thunder439/QNAS8/README.md

# QNAS8
8盘位3D打印NAS
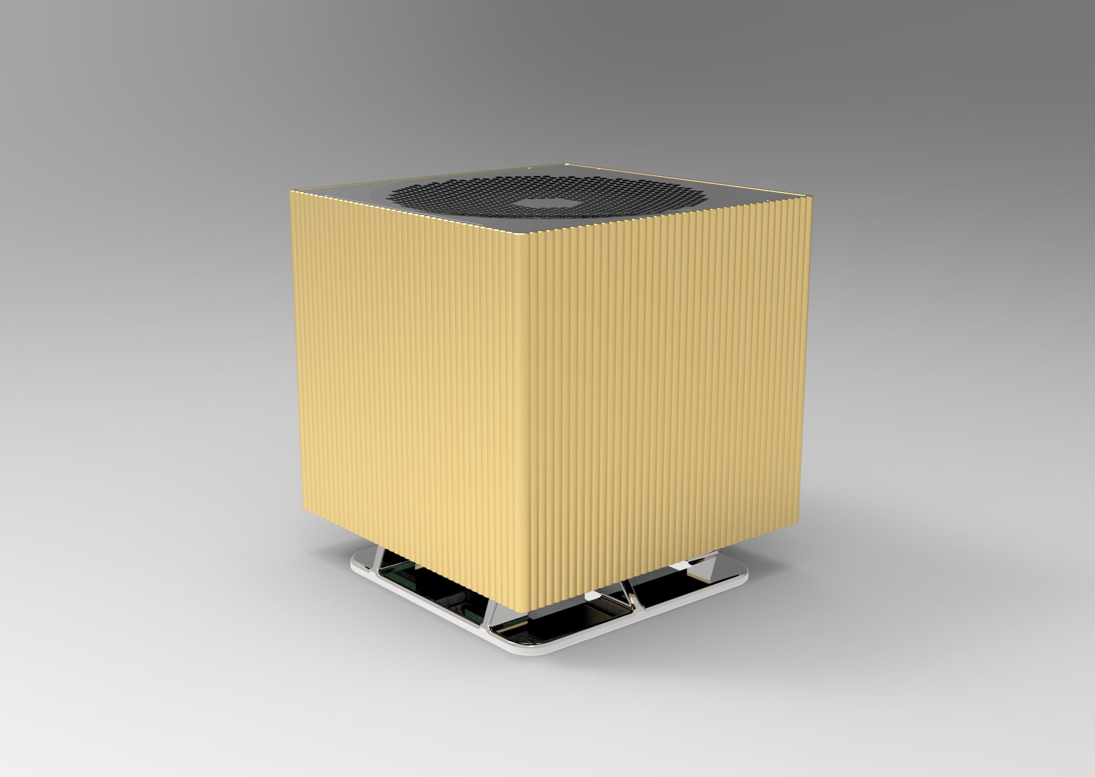
[picture p1: QNAS81.jpg]

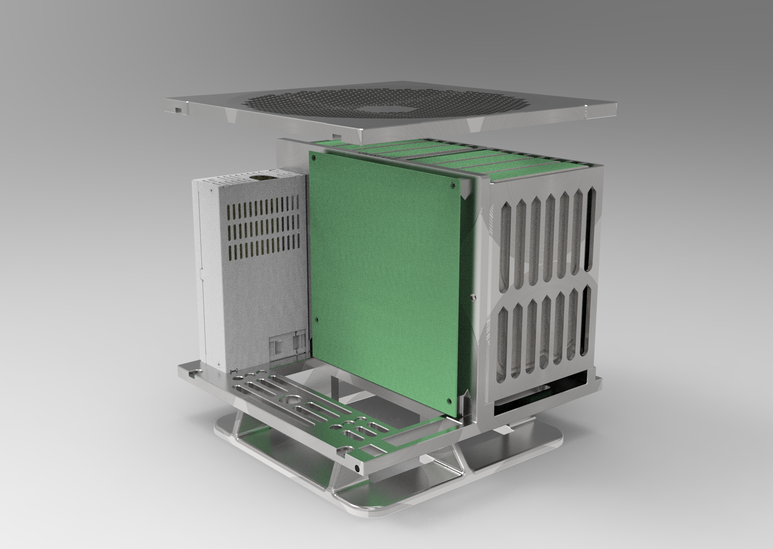
[picture p2: QNAS8内部.jpg]
