thunder439/QNAS8/Qnas8.jpg

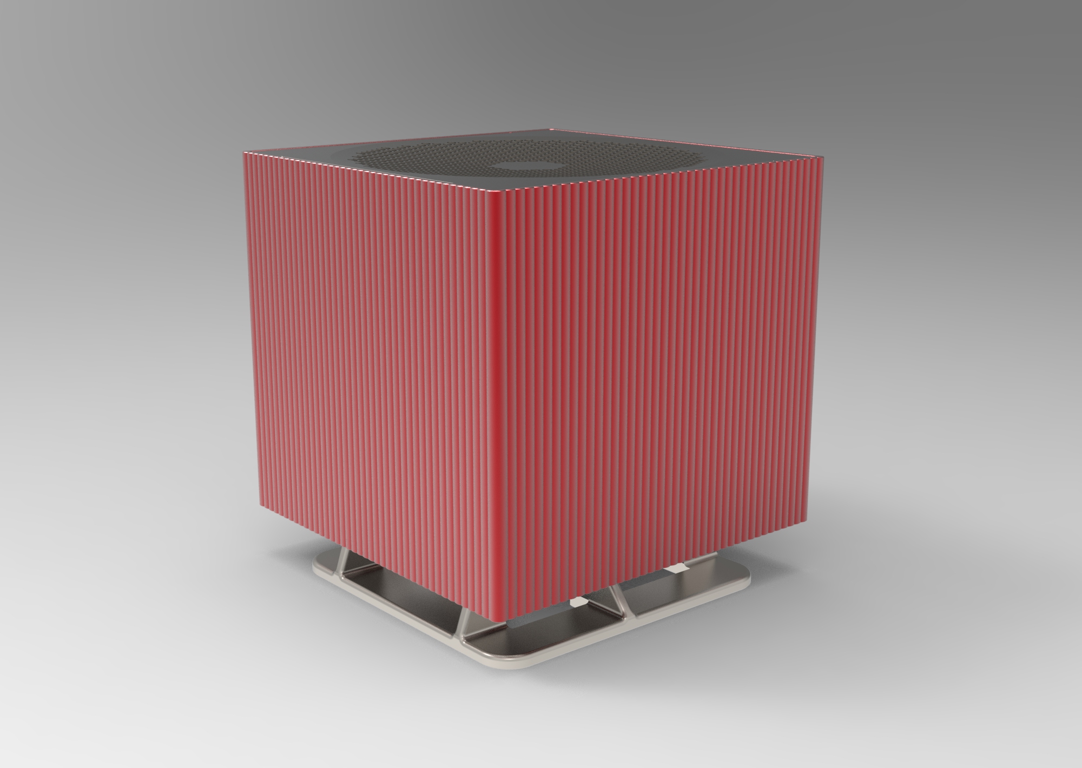
Qnas8.jpg
