thunder439/QNAS8/STL/新中框.STL

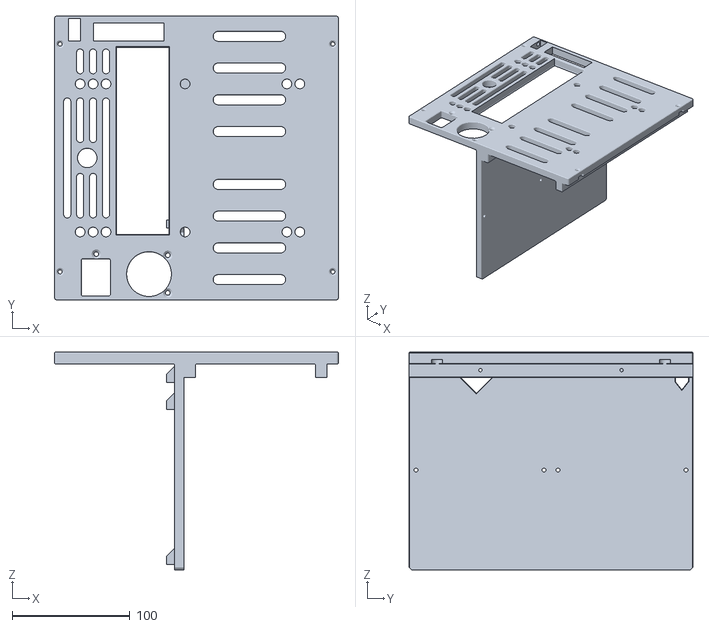
[picture p4: CAD file, 2023-04-15]
STL/新中框.STL
241.5 x 241.5 x 185.0
