thunder439/QNAS8/STL/硬盘笼实体.STL

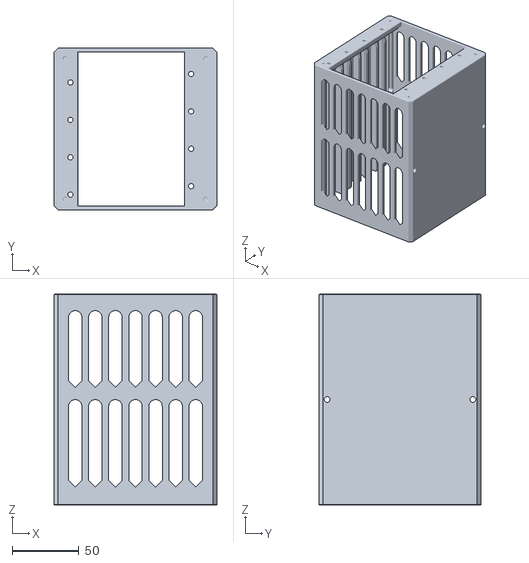
[picture p5: CAD file, 2023-04-15]
STL/硬盘笼实体.STL
121.4 x 120.7 x 157.5
