thunder439/QNAS8/STL/硬盘笼水滴版20230401.STL

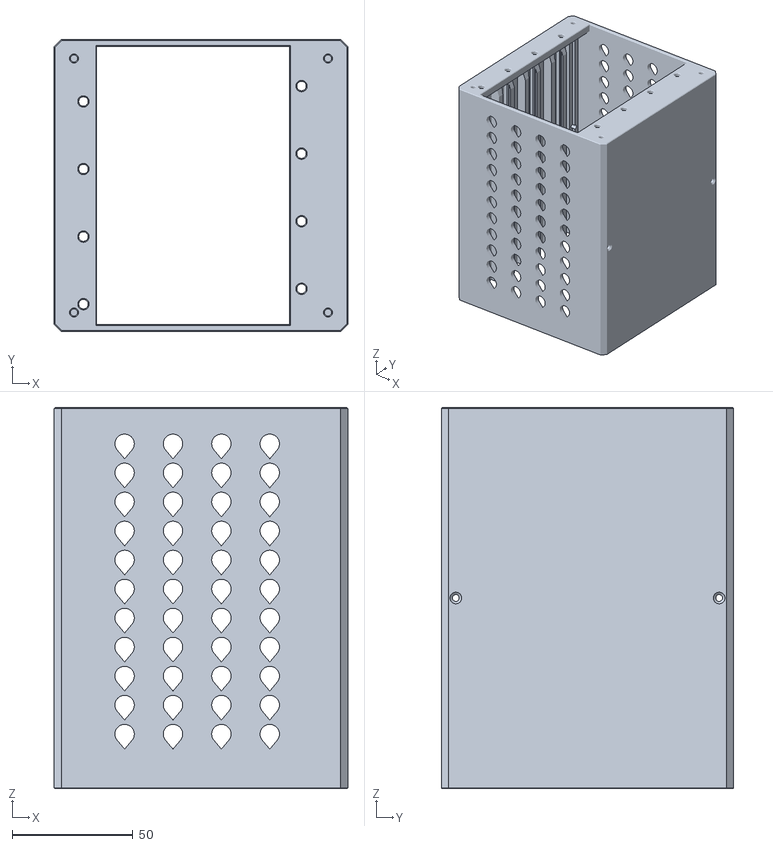
[picture p6: CAD file, 2023-04-15]
STL/硬盘笼水滴版20230401.STL
121.4 x 120.7 x 157.5
