thunder439/QNAS8/STL/外壳.STL

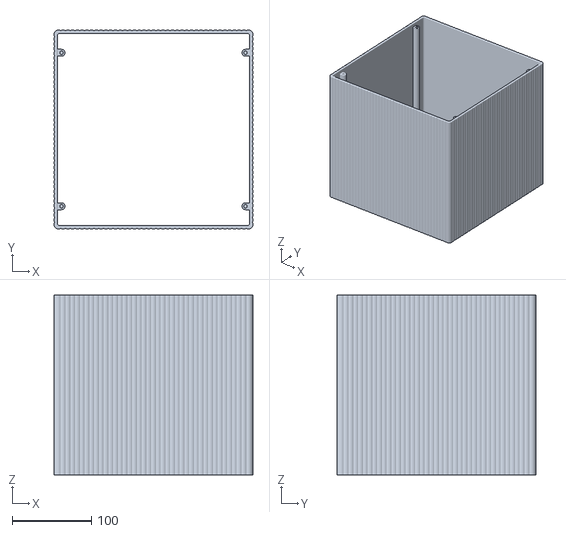
[picture p7: CAD file, 2023-04-15]
STL/外壳.STL
251.0 x 251.0 x 227.0
