thunder439/QNAS8/STL/光面外壳可以加纹理.STL

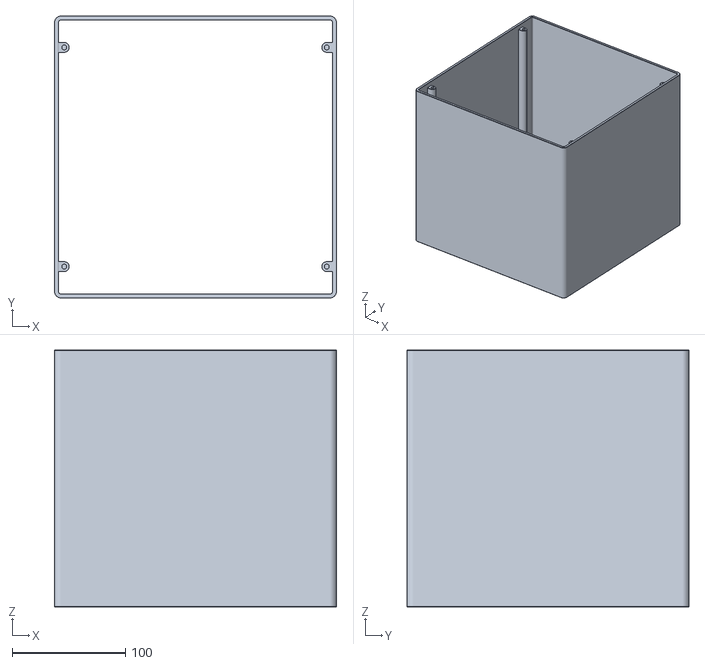
[picture p8: CAD file, 2023-04-15]
STL/光面外壳可以加纹理.STL
249.1 x 249.1 x 227.0
