thunder439/QNAS8/STL/底座.STL

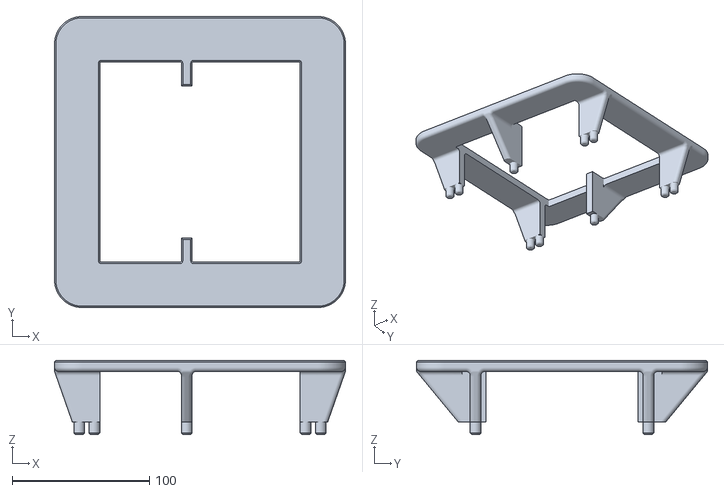
[picture p9: CAD file, 2023-04-15]
STL/底座.STL
212.0 x 212.0 x 54.0
