thunder439/QNAS8/STL/2.5寸固定板（未测试）.STL

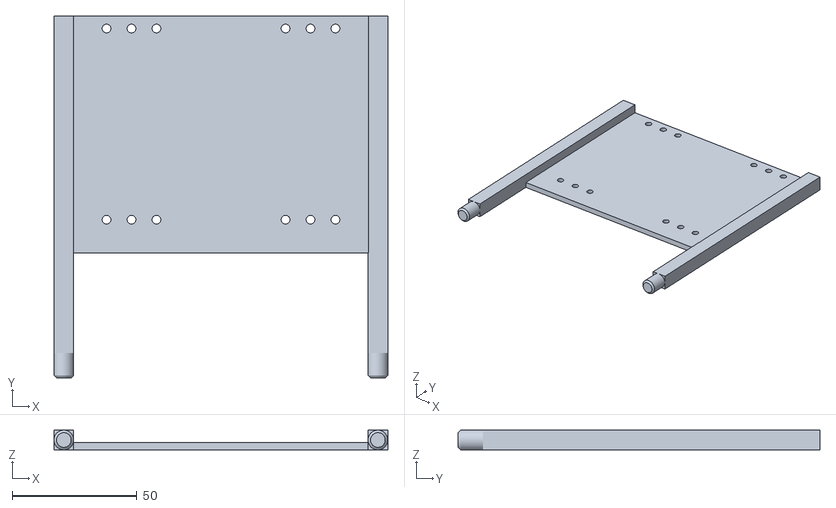
[picture p10: CAD file, 2023-04-15]
STL/2.5寸固定板（未测试）.STL
133.8 x 145.0 x 7.90
